dmclane/tces_499_stand_up_cart/README.md

# tces_499_stand_up_cart
Refurbishing a stand up cart for Multicare Childrens Therapy Unit
