dmclane/tces_499_stand_up_cart/Documentation/Fixed Pin Lables.docx

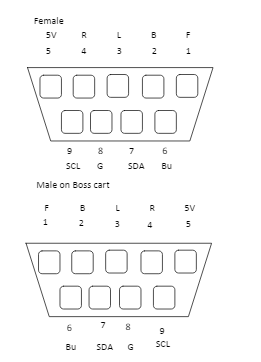
[picture p10: figure]

a
