dmclane/tces_499_stand_up_cart/Documentation/FrontPCB.pdf

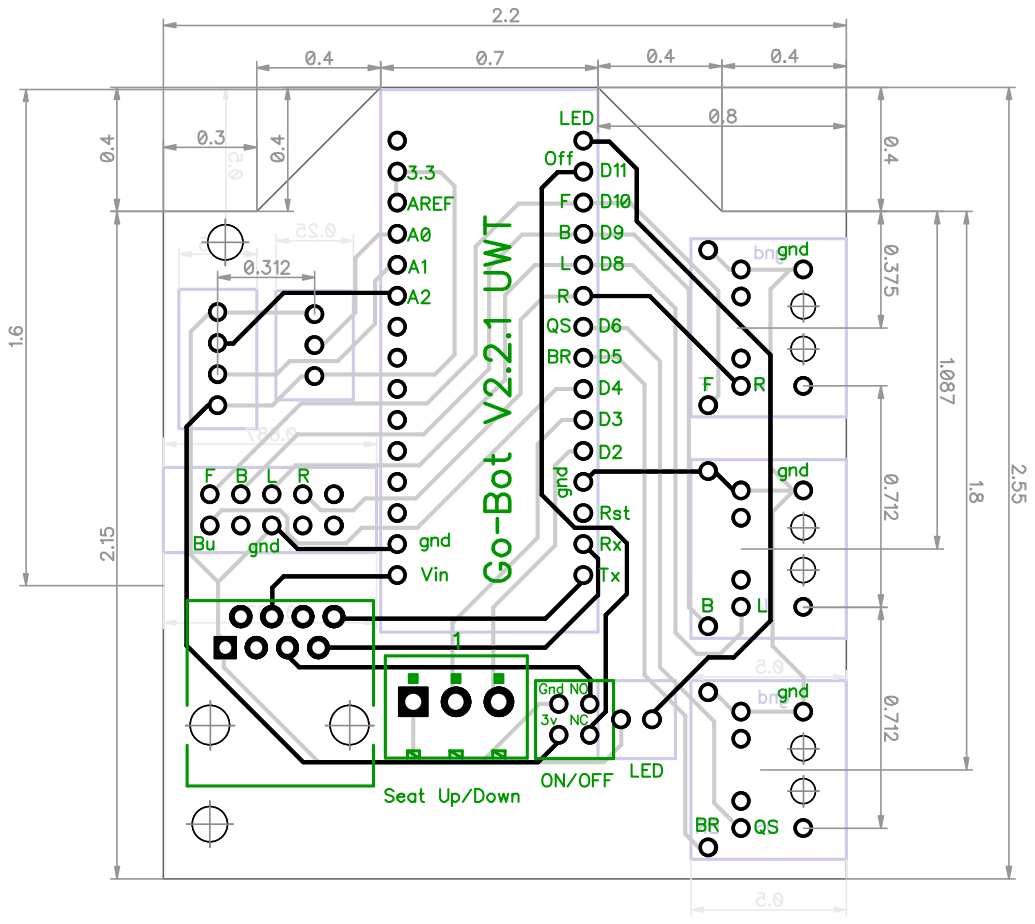
[picture p11: page 1]
