dmclane/tces_499_stand_up_cart/Documentation/RearPCB.pdf

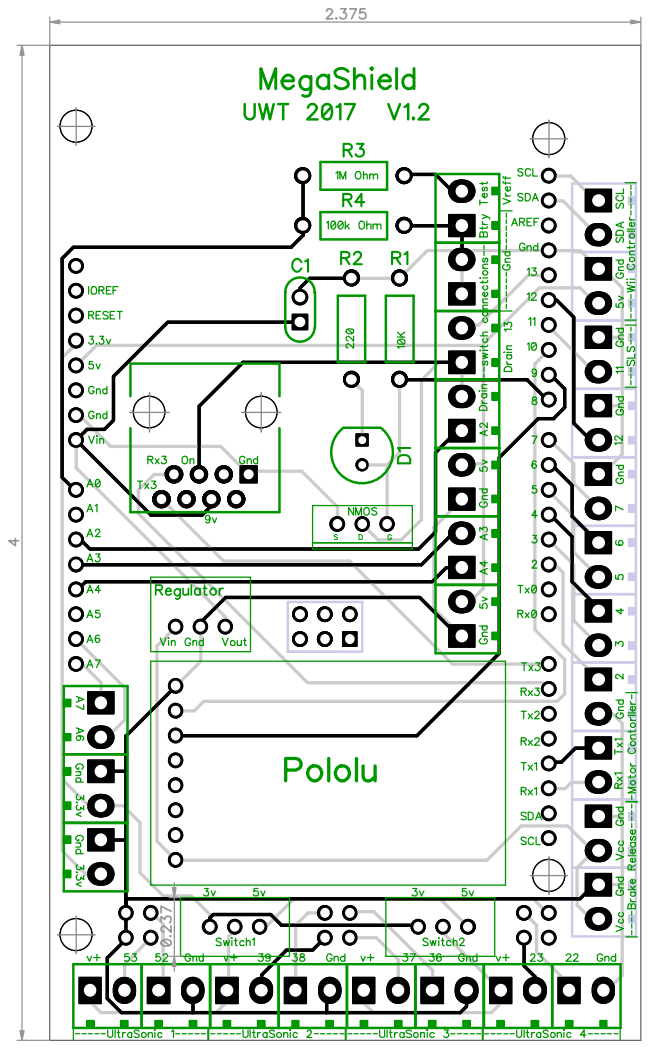
[picture p12: page 1]
