dmclane/tces_499_stand_up_cart/Documentation/User Control Guide.docx

Go-Bot User Control Guide

NOTE: Rear controls override front controls

The Wii nun-chuck controller is analog and can control the cart at varied speeds. The Atari controller is digital and only has one speed but is limited by acceleration parameters.

Rear Control System

A. Rear Controller Port: Plug Wii nun-chuck and Atari controllers into this port
B. Rear Power Button: Turns the cart on and off (Must hold for about 3 seconds to activate)
C. Low Battery Indicator (Red LED): Lights up when the battery is low

Front Control System

D. Miscellaneous Digital Out Button (White): Controls the Miscellaneous digital out jack (H)
E. LED (red): Lights up if cart is powered on and the front and back control systems are properly connected via CAT5 Cable
F. Front Control Port: Plug Atari controller into this port (Wii controller is not supported)
G. Digital Inputs: For use with buttons to control one action per button
H. Miscellaneous Digital Jack: May plug in light, horn, or any other add on to be controlled by the white button on top (D)
I. Kill Switch: Disengages power to the motors
J. Analog Stick: Moves the cart with analog input (similar to the Wii nun-chuck)
K. Speed Regulator Knob: Turn to adjust the max speed of the cart
L. Seat Control Switch: Push up to raise the seat and down to lower the seat
M. CAT 5 Cable: Connects the front control system to the rear control system
N. Front Power Button (Blue): Turns the cart on and off (the same as the Rear Power Button)

Wii Nun-Chuck controller

O. Analog stick: Moves the cart with analog input (overrides the front control system)
P. C Button: Kills the cart’s power while pressed
Q. Z Button: Kills the cart’s power while pressed

Atari controller

R. Button: Kills the cart’s power while pressed
S. Joy Stick: Moves the cart with digital input

Remote Controller Units

- Two components, large and small box
- Must plug small unit’s Male Controller Port into the Rear Control System Port
- Requires 4 AA batteries in larger unit which has Power Switch and Analog Stick
T. Power Switch: turns the controller on and off to extend battery life
U. Analog Stick: Moves the cart with analog input (similar to the Wii nun-chuck)
V. Male Controller Port: Plug this into the Rear Controller Port of the Rear Control System

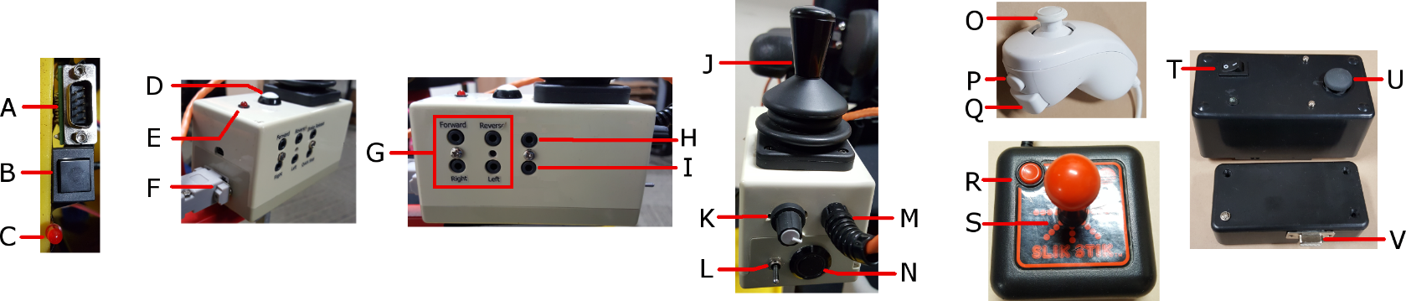
[picture p13: figure]
