dmclane/tces_499_stand_up_cart/(commit log)

2016-08-22 Create CurrentMega
2016-08-22 Create CurrentNano
2016-08-22 Update CurrentMega
2017-06-12 Uploading PCB files
2017-06-12 Create PCB
2017-06-20 Update CurrentNano
2017-06-28 most recent update as of June 27
    changes made to power/signal control, and some other stuff that I forget.
2017-07-07 Updated Mega
    Andrew and Jesse updated the LED Battery indicator, drive/turn values, and seat limit switch.
    Still needs:
    -Wii Controller
    -acceleration smoothing
